planeturban/muxmixer/README.md

# muxmixer

Arduino implemtation of audio separation solution described here: https://vintageisthenewold.com/amiga-audio-separation-solution/
