planeturban/muxmixer/eagle/main.brd

## EAGLE design eagle/main.brd (2019-11-11)

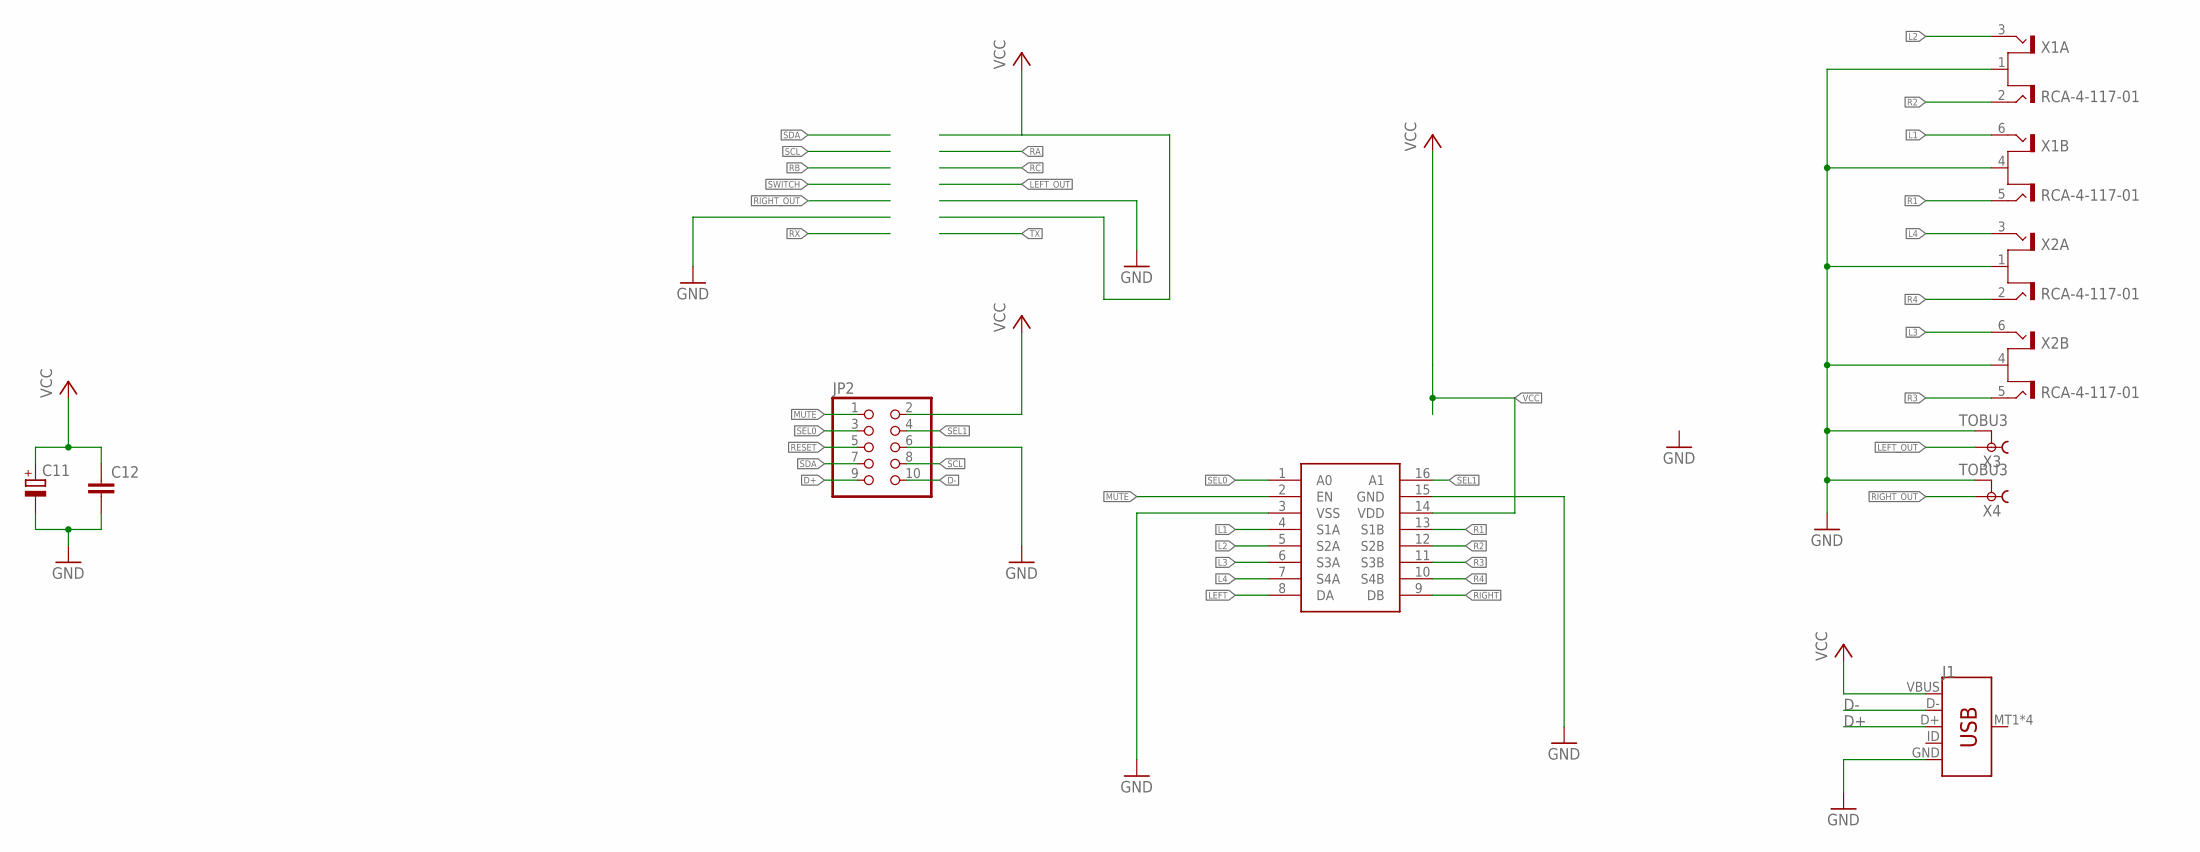
[picture p1: schematic main.sch, sheet 1]

Parts:
C11: 47uF; PANASONIC_D
C12: C-EUC1206; C1206
J1: USB_MICRO-B_SMT; USB-MICROB
JP2: PINHD-2X5; 2X05
U2: ADG709; TSSOP-16
X1, X2: RCA-4-117-01
X3, X4: TOBU3

Connections:
D+: J1.D+, JP2.9
D-: J1.D-, JP2.10
GND: C11.-, C12.2, J1.GND, JP2.6, U2.3 (VSS), U2.15 (GND), X1.1 (S), X1.4 (S), X2.1 (S), X2.4 (S), X3.2, X3.2@1 (2), X3.2@2 (2), X4.2, X4.2@1 (2), X4.2@2 (2); also elsewhere on the board
L1: U2.4 (S1A), X1.6 (T2)
L2: U2.5 (S2A), X1.3 (T2)
L3: U2.6 (S3A), X2.6 (T2)
L4: U2.7 (S4A), X2.3 (T2)
LEFT: U2.8 (DA); also elsewhere on the board
LEFT_OUT: X3.1; also elsewhere on the board
MUTE: JP2.1, U2.2 (EN)
R1: U2.13 (S1B), X1.5 (T1)
R2: U2.12 (S2B), X1.2 (T1)
R3: U2.11 (S3B), X2.5 (T1)
R4: U2.10 (S4B), X2.2 (T1)
RESET: JP2.5
RIGHT: U2.9 (DB); also elsewhere on the board
RIGHT_OUT: X4.1; also elsewhere on the board
SCL: JP2.8; also elsewhere on the board
SDA: JP2.7; also elsewhere on the board
SEL0: JP2.3, U2.1 (A0)
SEL1: JP2.4, U2.16 (A1)
VCC: C11.+, C12.1, J1.VBUS, JP2.2, U2.14 (VDD); also elsewhere on the board

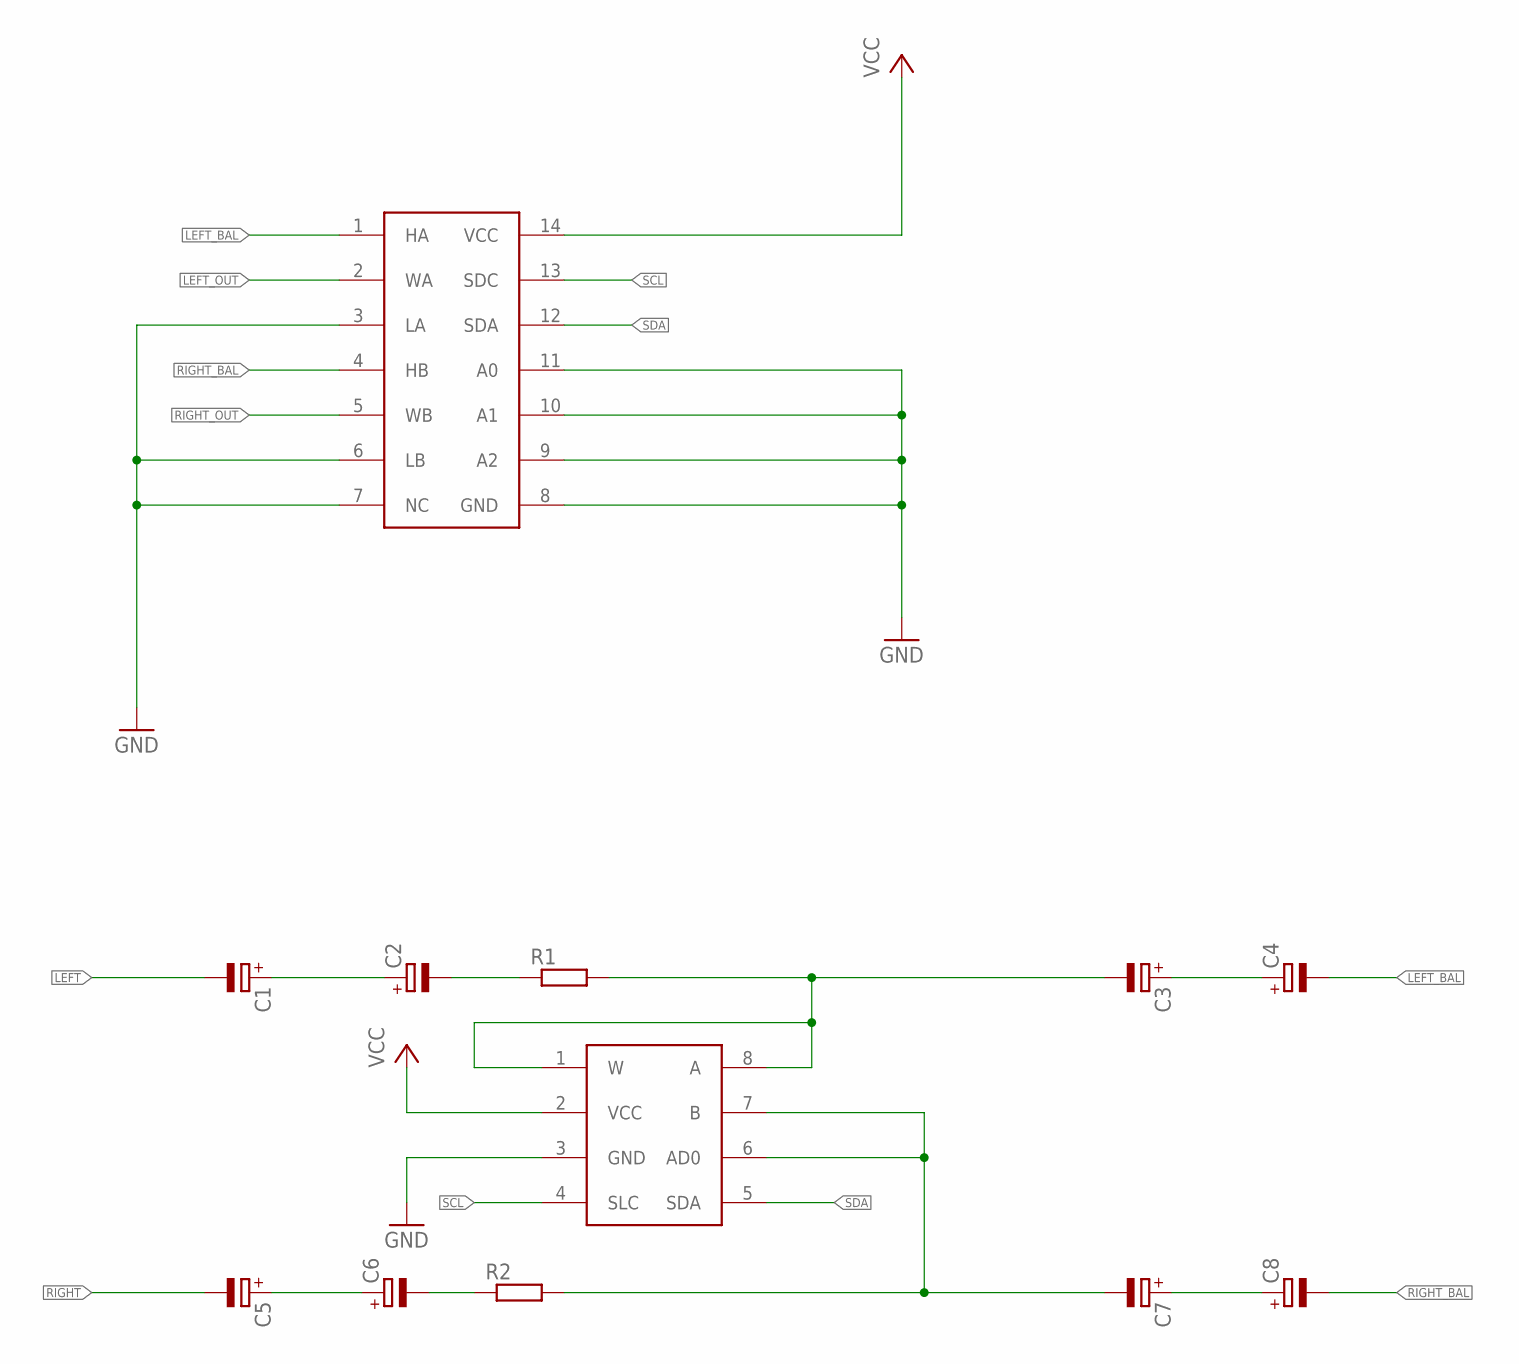
[picture p2: schematic main.sch, sheet 2]

Parts:
C1, C2, C3, C4, C5, C6, C7, C8: 47uF; PANASONIC_D
R1, R2: R-EU_M1206; M1206
U3: AD5273; SOT23-8
U4: MAX5387; TSSOP-14

Connections:
GND: U3.3 (GND), U4.3 (LA), U4.6 (LB), U4.7 (NC), U4.8 (GND), U4.9 (A2), U4.10 (A1), U4.11 (A0); also elsewhere on the board
LEFT: C1.-; also elsewhere on the board
LEFT_BAL: C4.-, U4.1 (HA)
LEFT_OUT: U4.2 (WA); also elsewhere on the board
unnamed: C1.+, C2.+
unnamed: C5.+, C6.+
unnamed: C7.-, R2.2, U3.6 (AD0), U3.7 (B)
unnamed: C7.+, C8.+
unnamed: C3.+, C4.+
unnamed: C2.-, R1.1
unnamed: C3.-, R1.2, U3.1 (W), U3.8 (A)
unnamed: C6.-, R2.1
RIGHT: C5.-; also elsewhere on the board
RIGHT_BAL: C8.-, U4.4 (HB)
RIGHT_OUT: U4.5 (WB); also elsewhere on the board
SCL: U3.4 (SLC), U4.13 (SDC); also elsewhere on the board
SDA: U3.5 (SDA), U4.12 (SDA); also elsewhere on the board
VCC: U3.2 (VCC), U4.14 (VCC); also elsewhere on the board

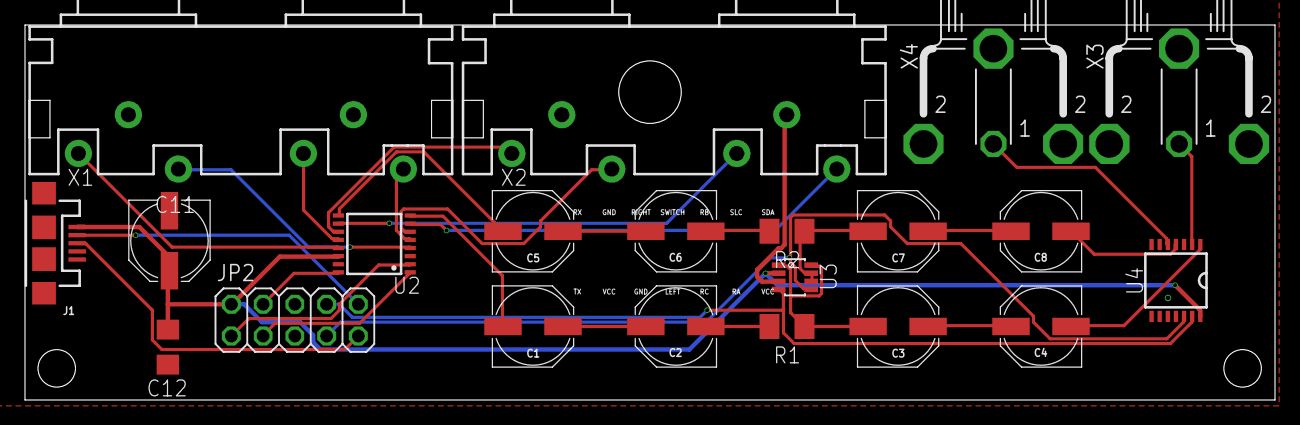
[picture p3: board main.brd from above]

Board: 2 copper layers, 100.0 x 30.0 mm, 21 parts (0 on the bottom side), 31 nets.
