planeturban/muxmixer/eagle/ctrl.brd

## EAGLE design eagle/ctrl.brd (2019-11-11)

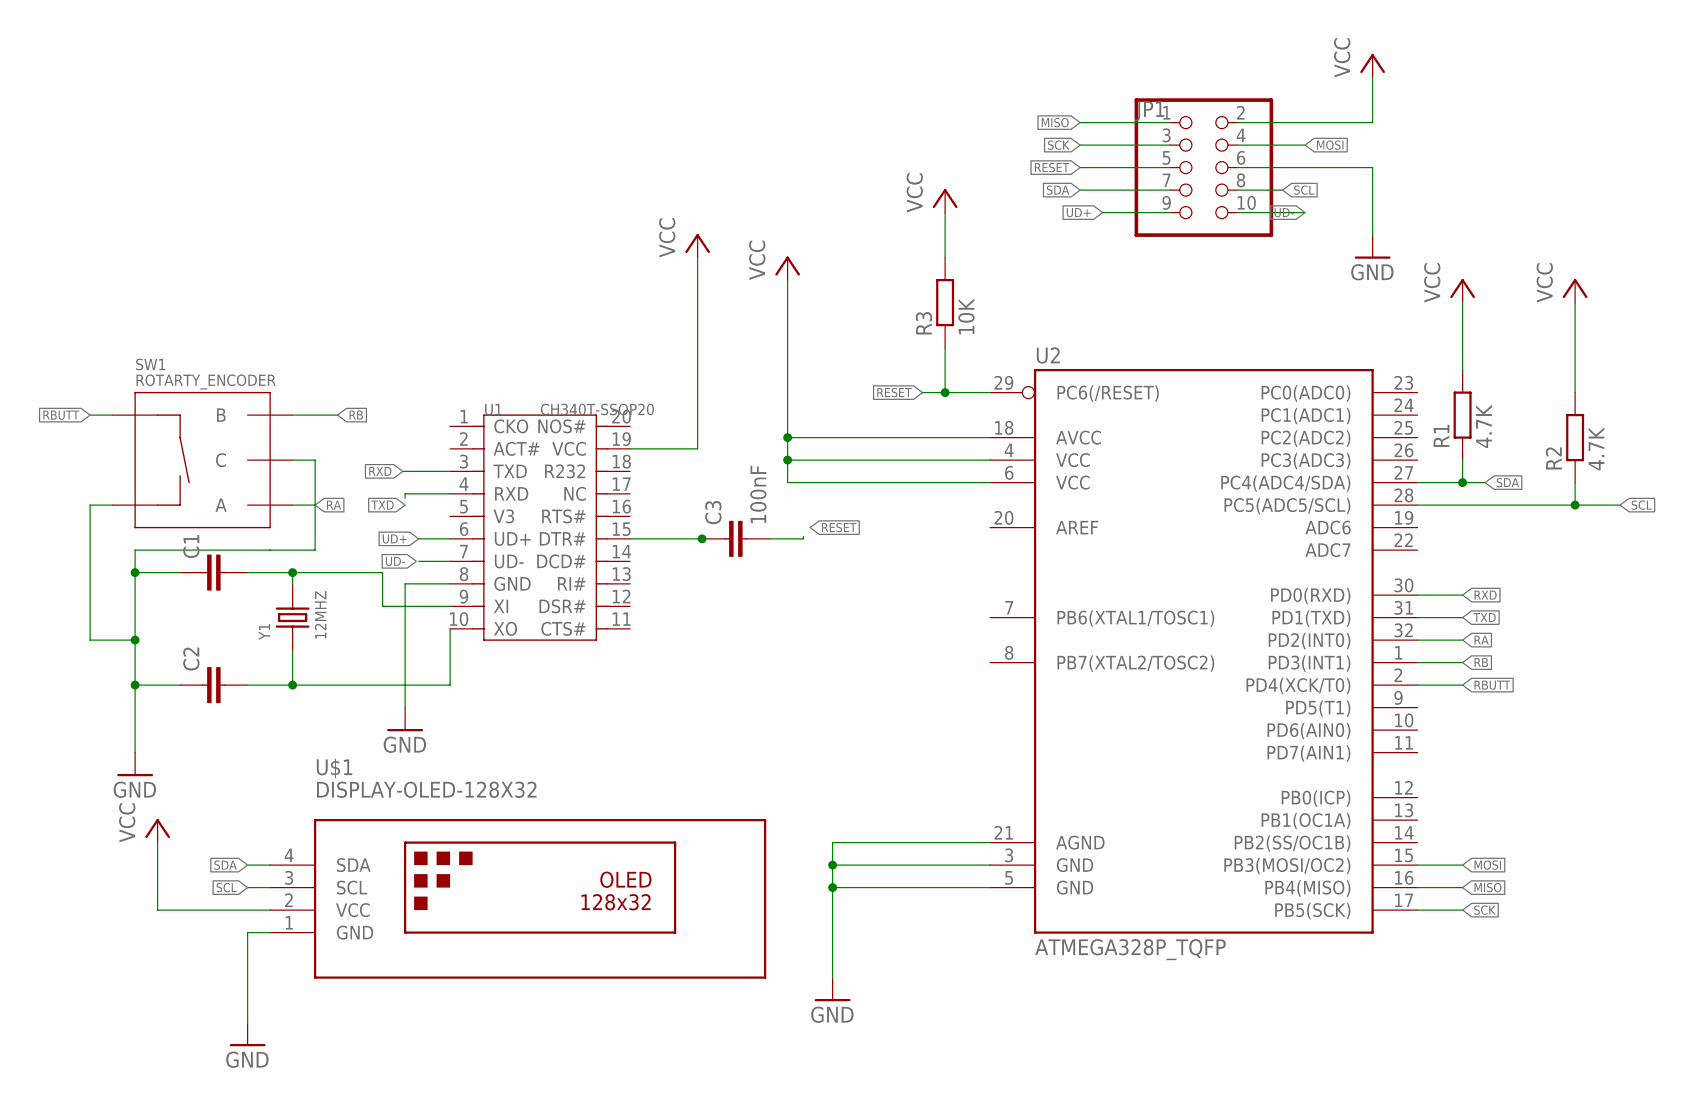
[picture p4: schematic ctrl.sch]

Parts:
C1, C2: C-EUC0805; C0805
C3: 100nF; C0805
JP1: PINHD-2X5; 2X05
R1, R2: 4.7K; M0805
R3: 10K; M0805
SW1: ROTARTY_ENCODER; ROTARY_ENC_PLAIN
U1: CH340T-SSOP20; SSOP20-0.65-7.6X5.2MM
U2: ATMEGA328P_TQFP; TQFP32-08
U$1: DISPLAY-OLED-128X32
Y1: 12MHZ; X2-SMD-5.0X3.2X1.3MM

Connections:
GND: C1.1, C2.1, JP1.6, SW1.C, SW1.SW-, U1.8 (GND), U2.3 (GND), U2.5 (GND), U2.21 (AGND), U$1.1 (GND)
MISO: JP1.1, U2.16 (PB4(MISO))
MOSI: JP1.4, U2.15 (PB3(MOSI/OC2))
unnamed: C1.2, U1.9 (XI), Y1.2
unnamed: C3.1, U1.15 (DTR#)
unnamed: C2.2, U1.10 (XO), Y1.1
RA: SW1.A, U2.32 (PD2(INT0))
RB: SW1.B, U2.1 (PD3(INT1))
RBUTT: SW1.SW+, U2.2 (PD4(XCK/T0))
RESET: C3.2, JP1.5, R3.1, U2.29 (PC6(/RESET))
RXD: U1.3 (TXD), U2.30 (PD0(RXD))
SCK: JP1.3, U2.17 (PB5(SCK))
SCL: JP1.8, R2.1, U2.28 (PC5(ADC5/SCL)), U$1.3 (SCL)
SDA: JP1.7, R1.1, U2.27 (PC4(ADC4/SDA)), U$1.4 (SDA)
TXD: U1.4 (RXD), U2.31 (PD1(TXD))
UD+: JP1.9, U1.6 (UD+)
UD-: JP1.10, U1.7 (UD-)
VCC: JP1.2, R1.2, R2.2, R3.2, U1.19 (VCC), U2.4 (VCC), U2.6 (VCC), U2.18 (AVCC), U$1.2 (VCC)

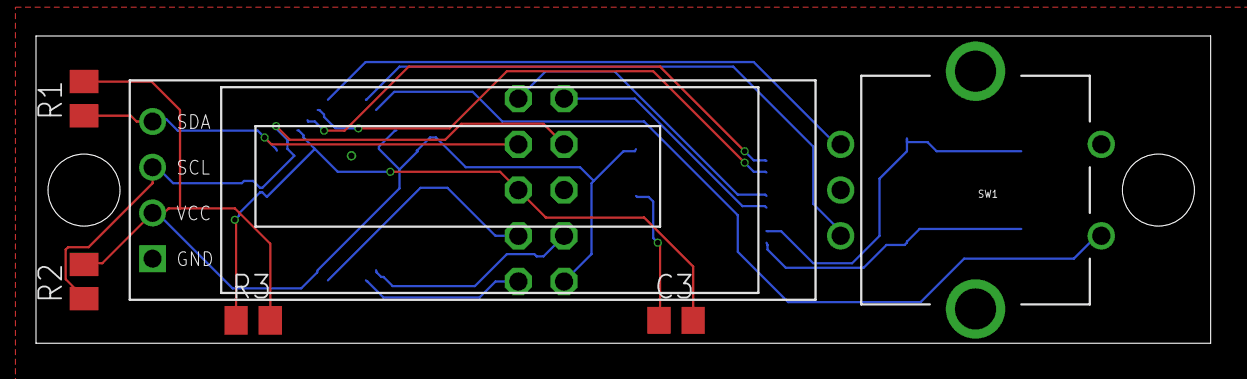
[picture p5: board ctrl.brd from above]

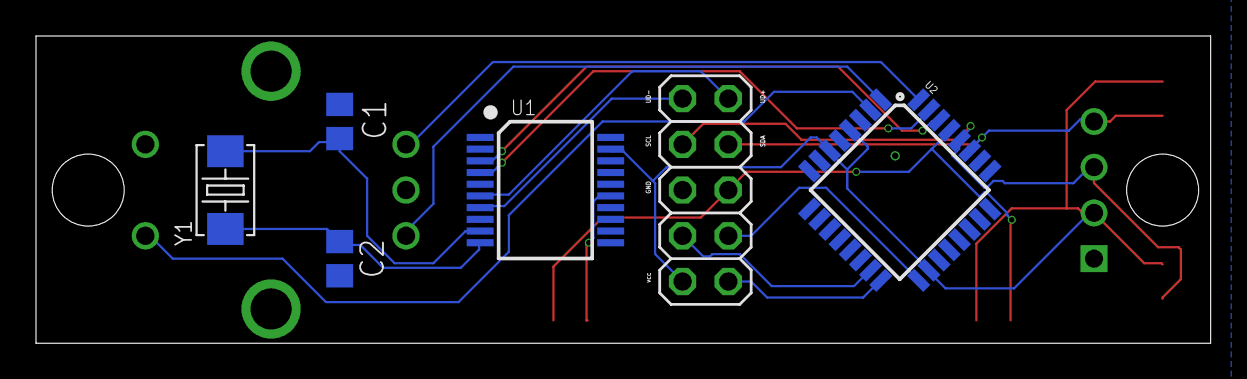
[picture p6: board ctrl.brd from below]

Board: 2 copper layers, 65.3 x 17.1 mm, 12 parts (6 on the bottom side), 18 nets.
