planeturban/muxmixer/(commit log)

2019-11-11 To compensate for my bad soldering skills..
2019-11-11 Eagle files
    [ctrl.brd, ctrl.sch, main.brd, main.sch]
